AgenttiX/proportional-counter/README.md

# Proportional counter




[University of Helsinki](https://www.helsinki.fi/)
[PAP328 Laboratory Course on Instrumentation](https://courses.helsinki.fi/en/pap328)
project work:
[proportional counter](https://en.wikipedia.org/wiki/Proportional_counter)

In this project we built a radiation detector based on a
[drink can](https://en.wikipedia.org/wiki/Drink_can).
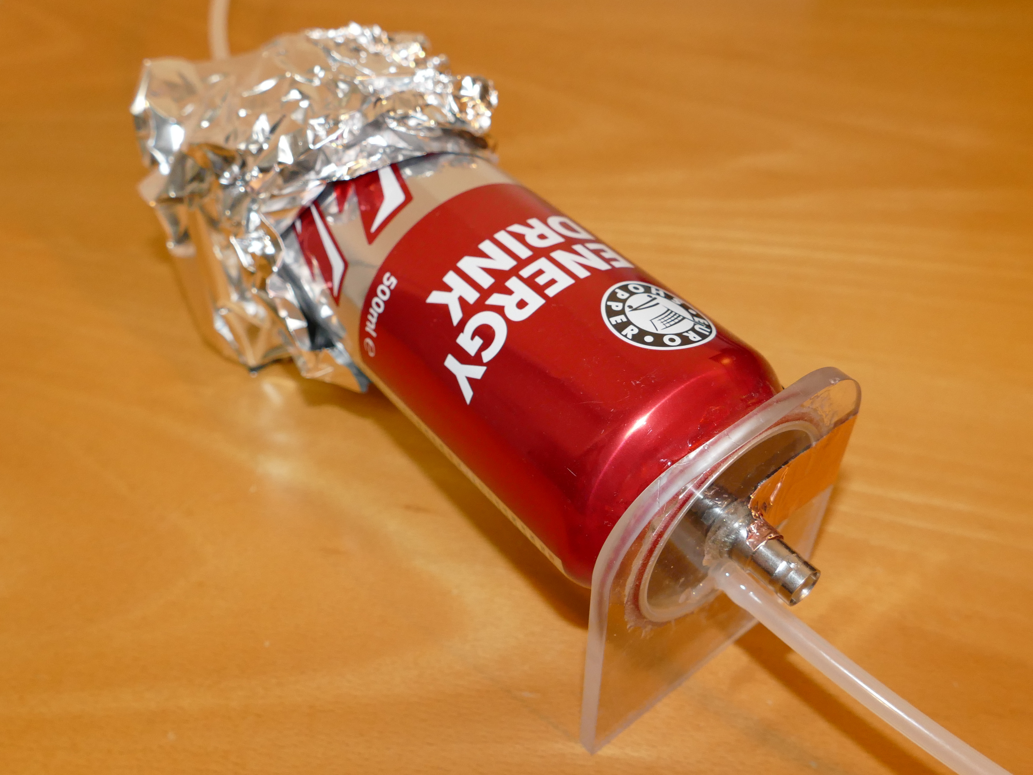
[picture p1: report/fig/P1170853-cropped.jpg]
Detector


We also built a pre-amplifier for the signal produced by the detector.
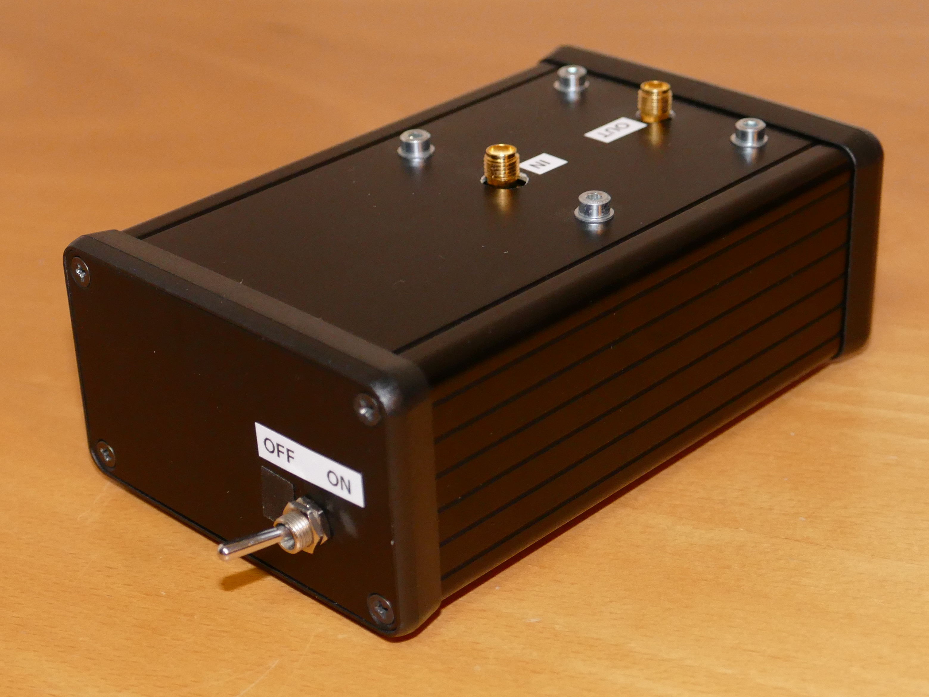
[picture p2: report/fig/P1170874-cropped.jpg]
Pre-amplifier


The setup was tested with radioactive sources of both
<sup>241</sup>Am and <sup>55</sup>Fe isotopes.
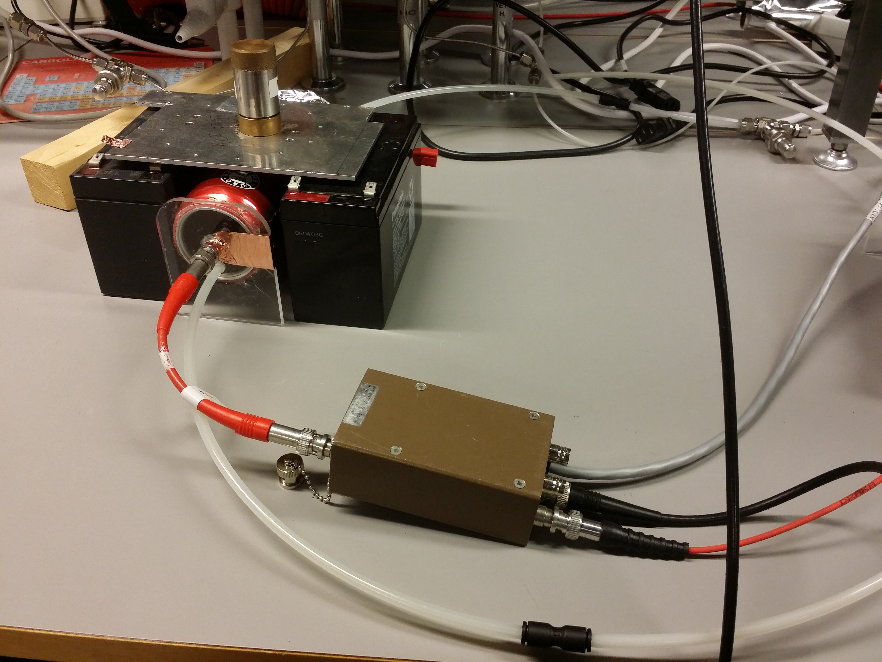
[picture p3: report/fig/IMG_20201130_144418.jpg]
Lab setup
