AgenttiX/proportional-counter/report/fig/IMG_20201005_104331.jpg

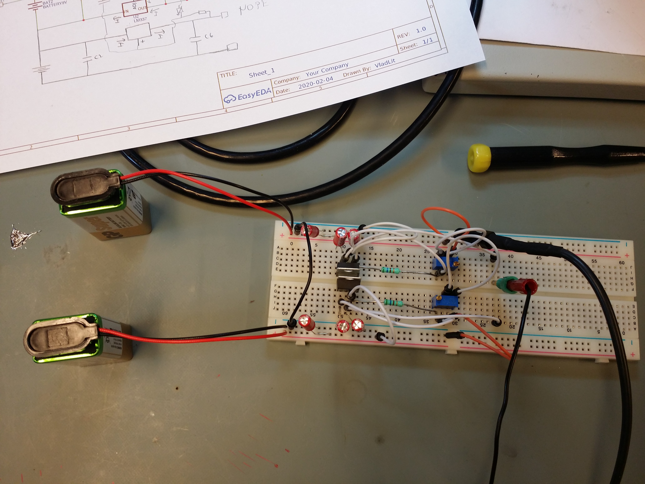
report/fig/IMG_20201005_104331.jpg
