AgenttiX/proportional-counter/report/fig/IMG_20201117_111841.jpg

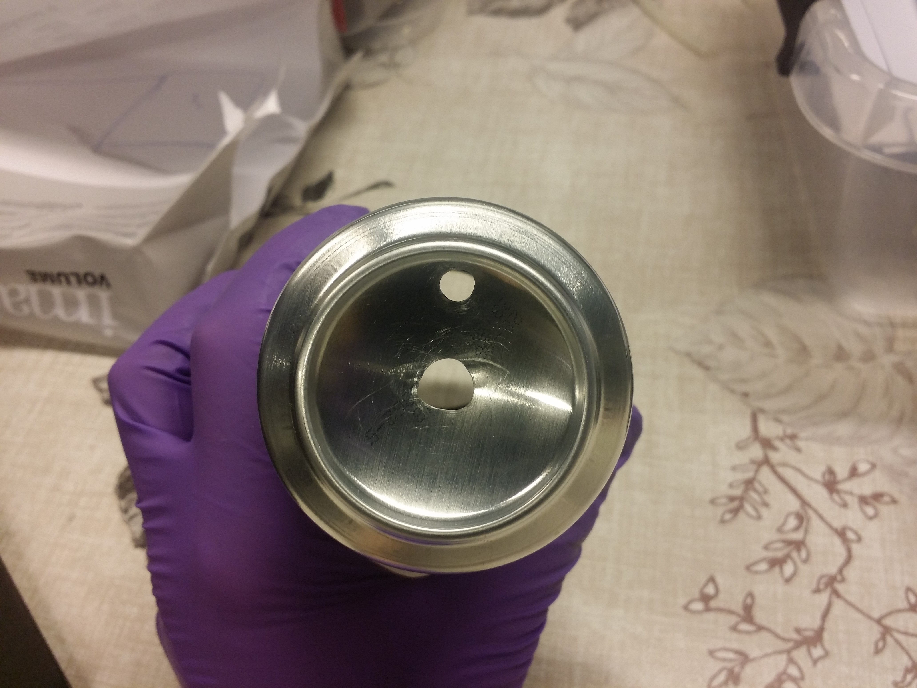
report/fig/IMG_20201117_111841.jpg
