AgenttiX/proportional-counter/report/fig/IMG_20201201_113615.jpg

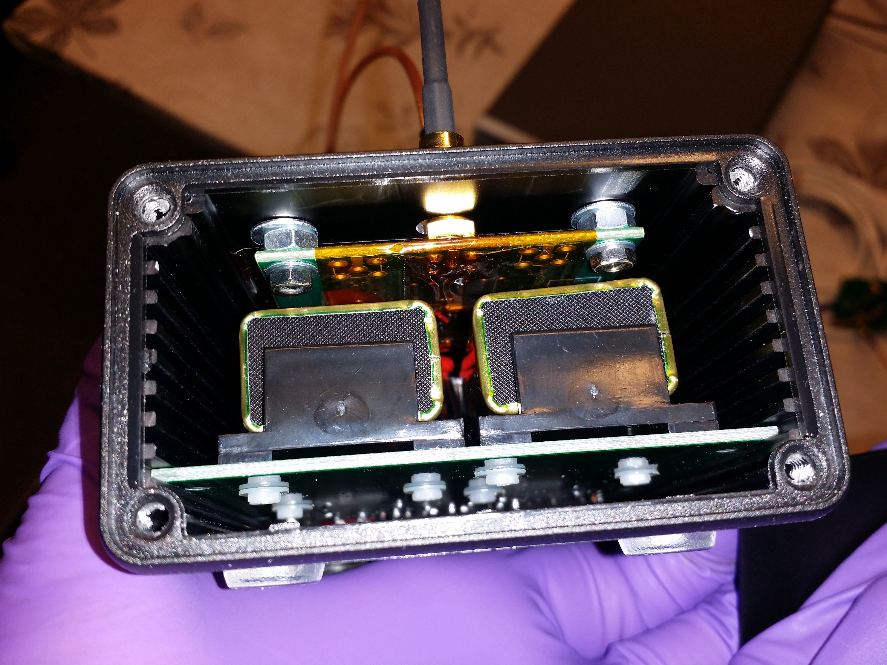
report/fig/IMG_20201201_113615.jpg
