AgenttiX/proportional-counter/report/fig/IMG_20201201_121601.jpg

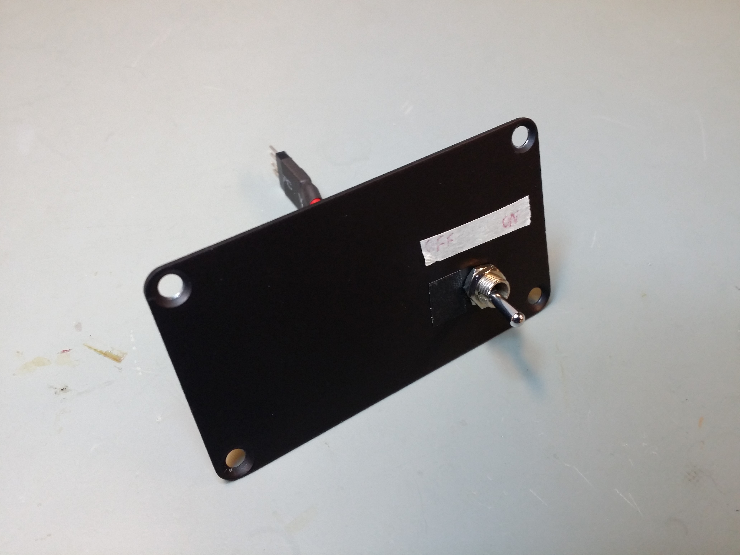
report/fig/IMG_20201201_121601.jpg
