AgenttiX/proportional-counter/report/fig/IMG_20201201_121611.jpg

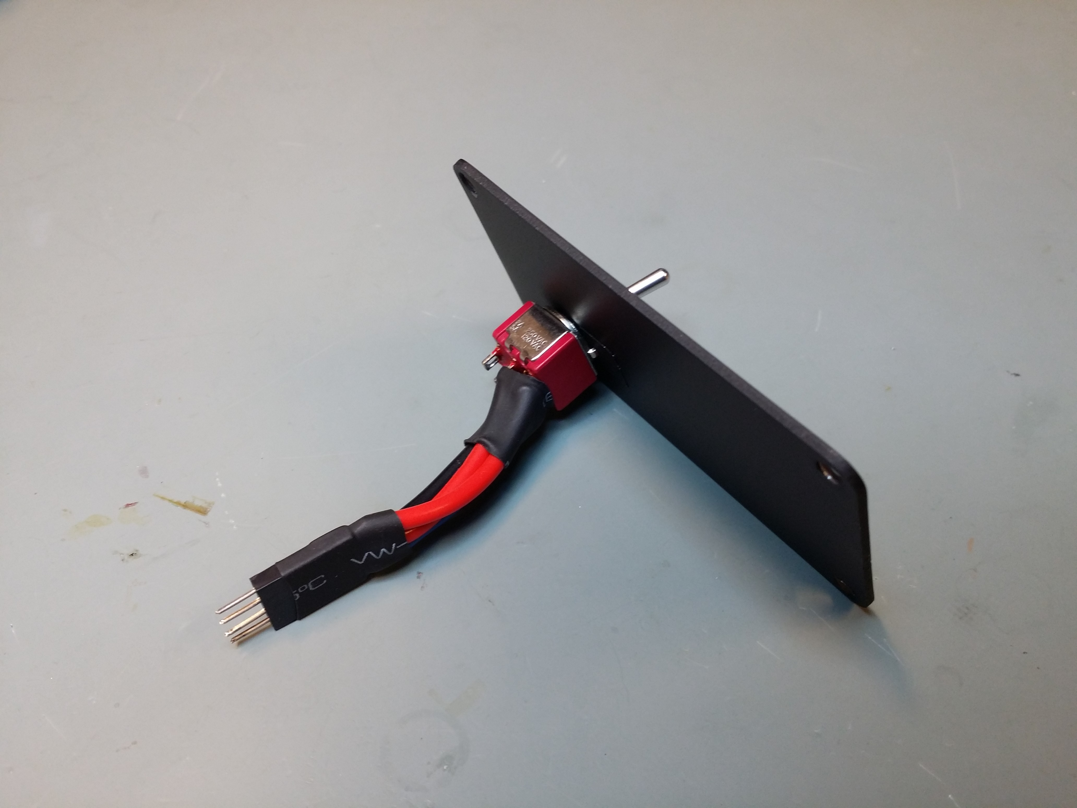
report/fig/IMG_20201201_121611.jpg
