AgenttiX/proportional-counter/report/fig/IMG_20201201_121625.jpg

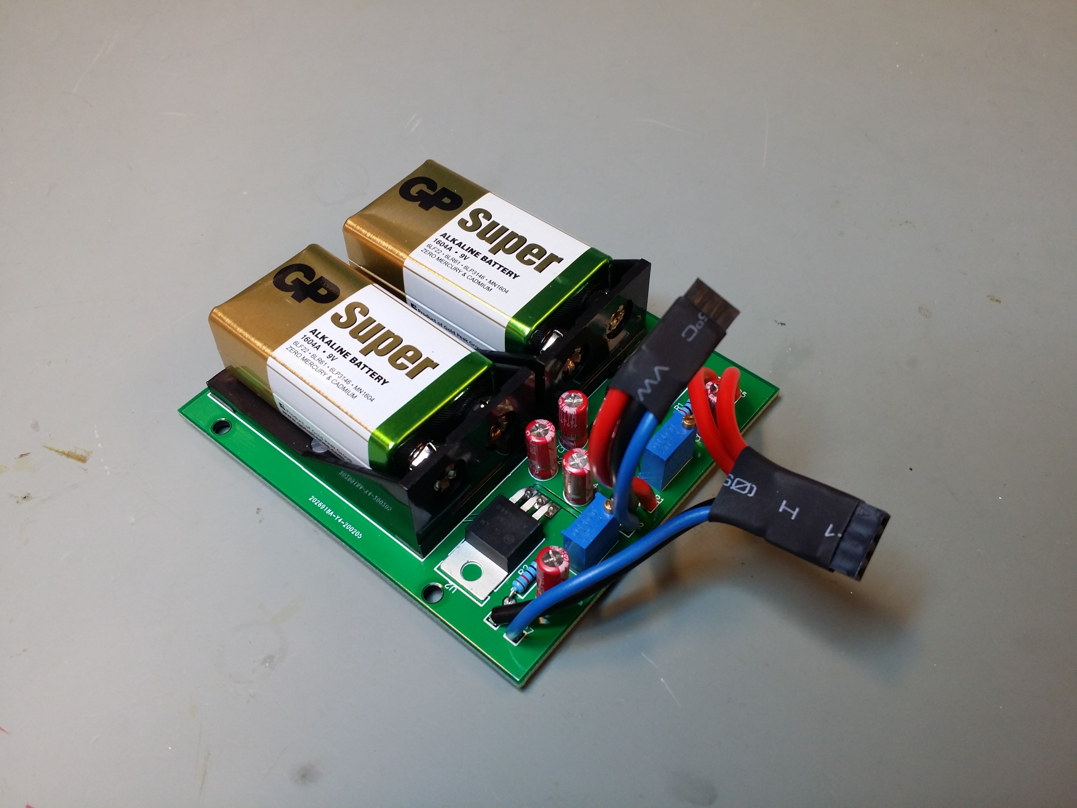
report/fig/IMG_20201201_121625.jpg
