AgenttiX/proportional-counter/report/fig/IMG_20201201_121635.jpg

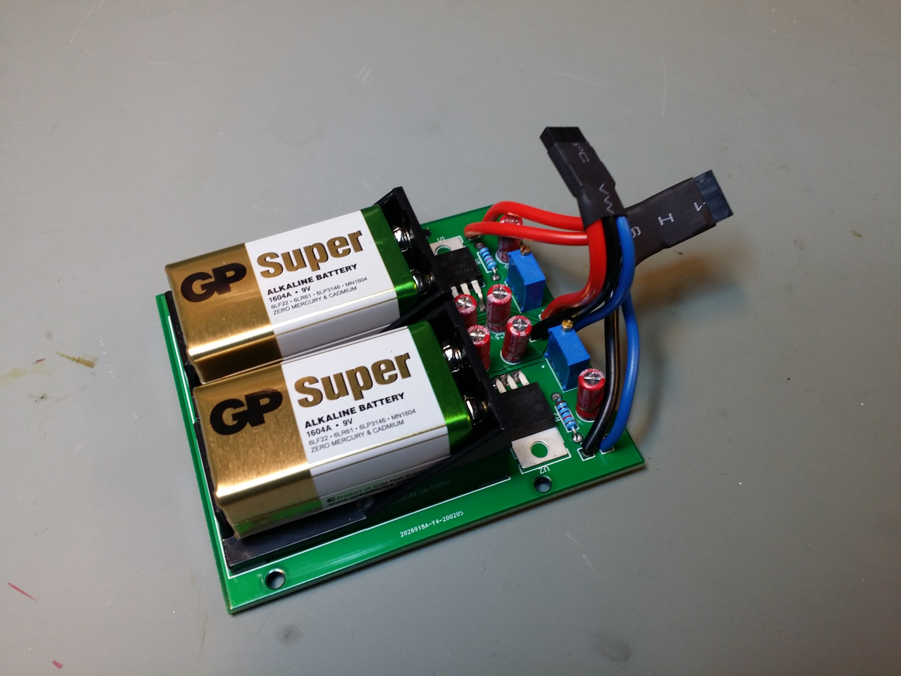
report/fig/IMG_20201201_121635.jpg
