AgenttiX/proportional-counter/report/fig/IMG_20201201_121728.jpg

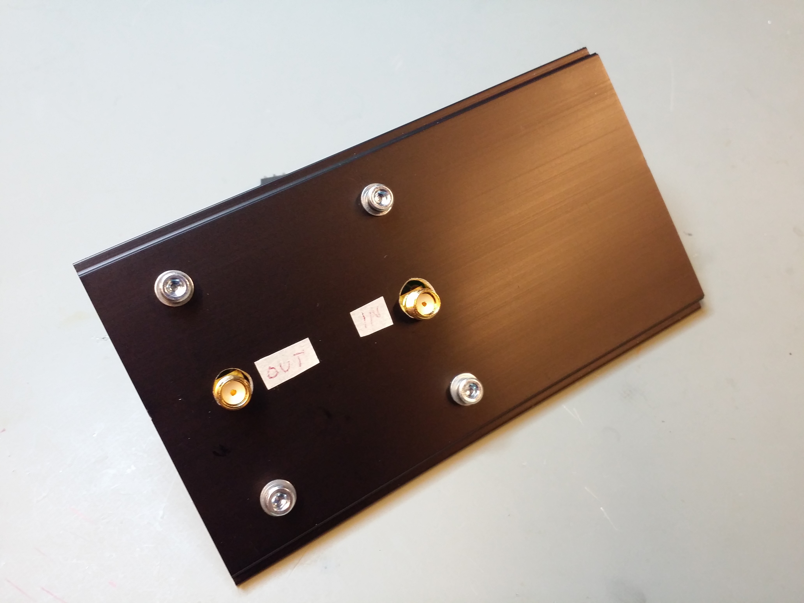
report/fig/IMG_20201201_121728.jpg
