AgenttiX/proportional-counter/report/fig/IMG_20201201_121735.jpg

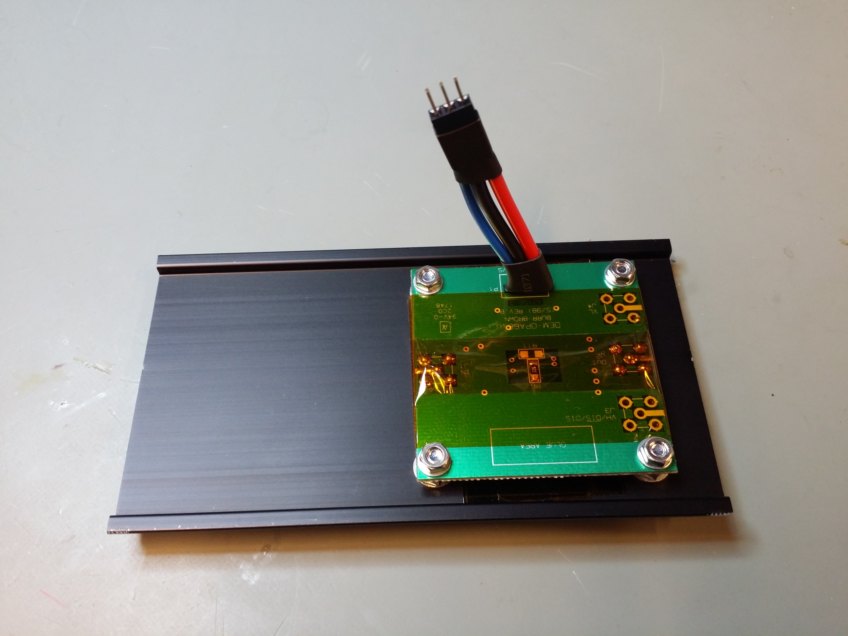
report/fig/IMG_20201201_121735.jpg
