AgenttiX/proportional-counter/report/fig/IMG_20201207_113407.jpg

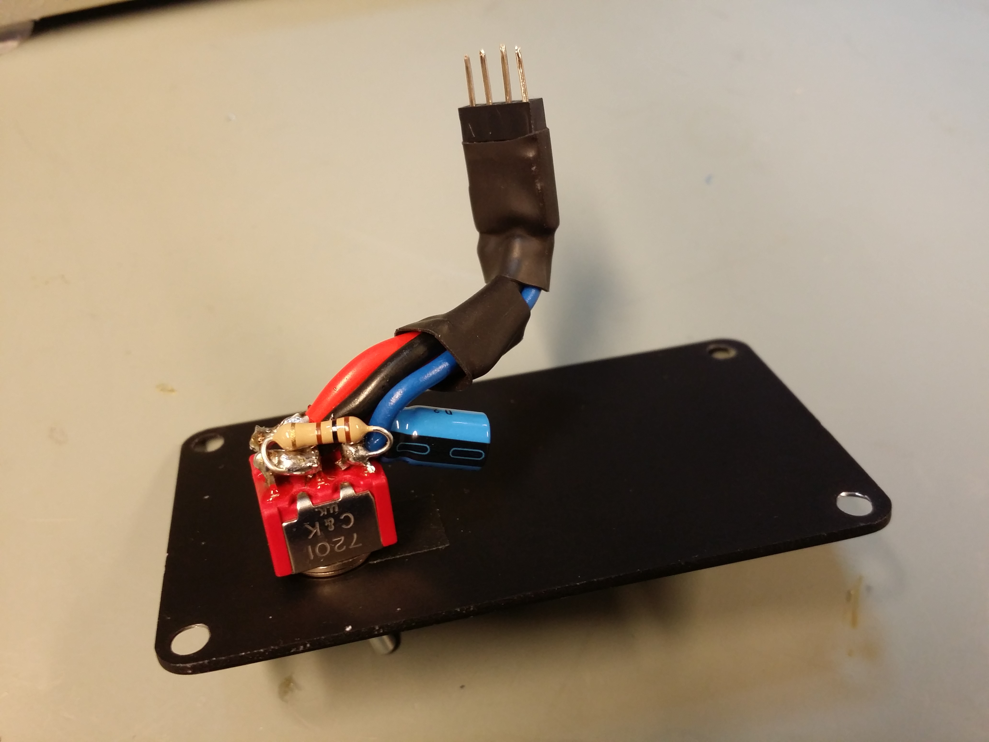
report/fig/IMG_20201207_113407.jpg
