AgenttiX/proportional-counter/report/fig/IMG_20201207_121010.jpg

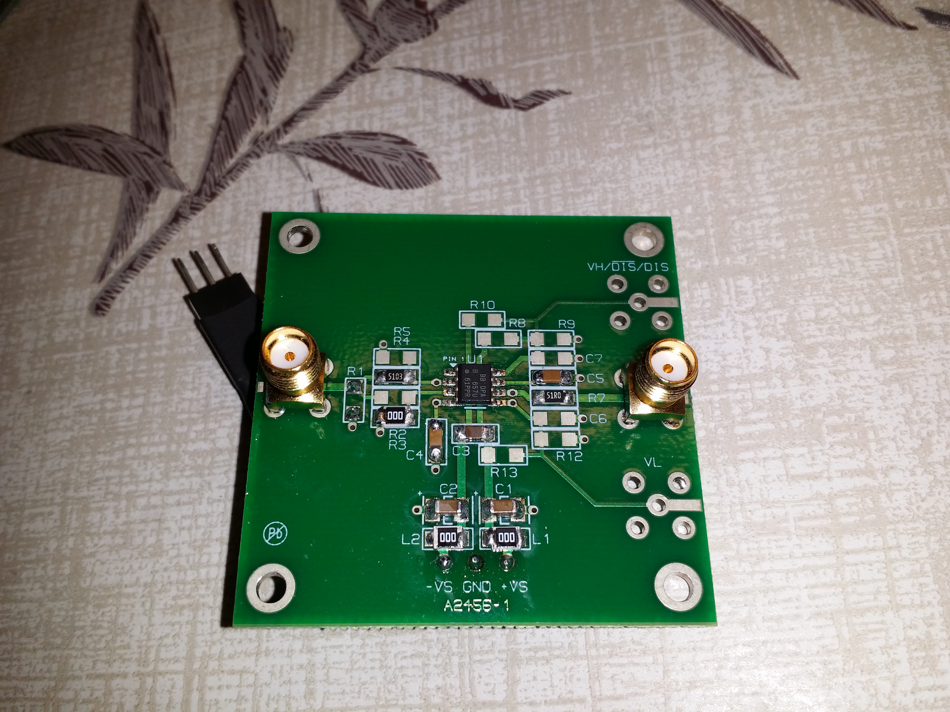
report/fig/IMG_20201207_121010.jpg
