AgenttiX/proportional-counter/report/fig/IMG_20201207_131734.jpg

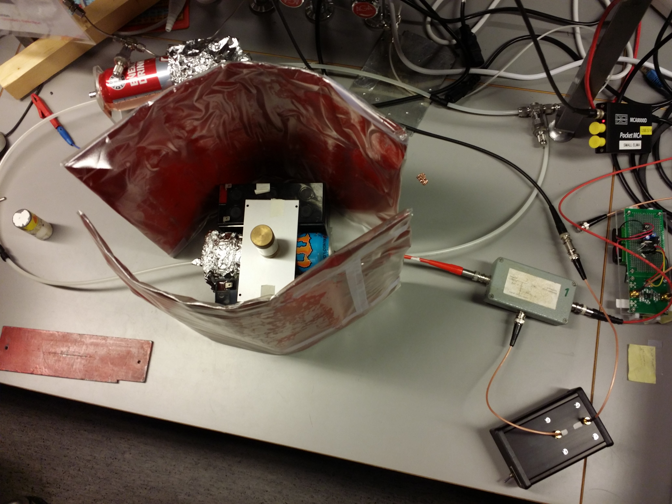
report/fig/IMG_20201207_131734.jpg
