AgenttiX/proportional-counter/analysis/data/notes/measurement_day.ods

Measurement day 1
2020-11-30
Pulser test
Output voltages (mV, measured with oscilloscope)
50,7
52,7
51,3
50,7
51,3
Voltage setting (mV)
0,305
Rise time (ns)
456
457
450
452
456
Traces 0-5 are without rise and fall times, and traces 6-10 are with
Without 10x attenuation
Output voltages (mV, measured with oscilloscope)
500
507
493
500
493
Traces 11-15
These were with 1 MOhm termination, so let’s do new measurements to fix things
With 10x attenuation
Output voltages (mV, measured with oscilloscope)
49,3
50
51,3
49,3
50,7
Voltage setting (mV) |  | Traces 16-20
0,305
Rise time (ns)
~ 600
Fall time (µs)
~ 200
Without 10x attenuation
Output voltages (mV, measured with oscilloscope)
480
487 |  | Traces 21-25
480
487
480
We then tried connecting the system through the gain module, but the output voltage was too high with the 10x attenuation
With lower output voltage
With 10x attenuation
Output voltages (mV, measured with oscilloscope)
24,7
24,3
24,7
23,7
26,3
Rise time (ns)
460
425
430
415
444
Fall time (µs)
190
200
177
202
154
Voltage setting (mV)
0,275
Traces 26-30
Without 10x attenuation
Output voltages (mV, measured with oscilloscope)
223 |  | 226
227
230
220
230
Rise time (ns)
453
455
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
