AgenttiX/proportional-counter/analysis/data/attenuator_test.csv

Attenuation setting | Input A (V) | Output A (V)
10 | 1 | 1.01
9 | 1 | 0.88
8 | 1 | 0.72
7 | 1 | 0.688
6 | 1 | 0.6
5 | 1 | 0.504
4 | 1 | 0.4
3 | 1 | 0.296
2 | 1 | 0.176
1 | 1 | 0.104
0 | 1 | 0
