AgenttiX/proportional-counter/analysis/data/preamp/gain_test.csv

Attenuation setting | Input A (V) | Output A (V)
10 | 0.1 | 2.14
9 | 0.1 | 1.88
8 | 0.1 | 1.56
7 | 0.1 | 1.44
6 | 0.1 | 1.3
5 | 0.1 | 1.08
4 | 0.1 | 0.86
3 | 0.1 | 0.67
2 | 0.1 | 0.38
1 | 0.1 | 0.22
0 | 0.1 | 0.1
