AgenttiX/proportional-counter/(commit log)

2020-11-30 Add calibration data
2020-12-08 Add calibration analysis
2020-12-26 Add assembly chapter
2020-12-26 Add calibration chapter and MCA calibration figure
2020-12-26 Disable Numba as it does not currently work on Python 3.9
2020-12-27 Add other measurement notes
    [measurement_day.ods, oscilloscope_measurement.ods]
2020-12-31 Add a preliminary circuit diagram for the pre-amplifier
    [amplifier.sch]
2021-01-01 Add amplifier schematic png
2021-01-02 Fix R6 resistance in the amplifier schematic
    [amplifier.sch]
2021-01-02 Add pre-amp schematic to the report
2021-01-02 Add error text to amp calibration fit
2021-01-02 Improve calibration figures
2021-01-03 Improve calibration analysis
2021-01-03 Add pre-amplifier analysis
    [attenuator_test.csv, gain_test.csv, preamp_frequency_response.csv]
2021-01-03 Improve calibration and testing chapters
2021-01-06 Add HV scan charge figure and restructure the code
2021-01-06 Add HV scan charge figure to the report
2021-02-15 Make schematic figure smaller
2021-02-15 Add titles and more prints for pre-amp analysis
2021-02-22 Add device model notes
2021-04-09 Fix calibration plot legend
2021-04-09 Fix measured charges and gas multiplication factors
2021-04-09 Add energy calibration figure
2021-04-09 Add anode wire diameter printing
2021-04-11 Move pulser calibration to an appendix
